zvictory/cashflow/3d-models/toy-dump-truck/stl/02_chassis.stl

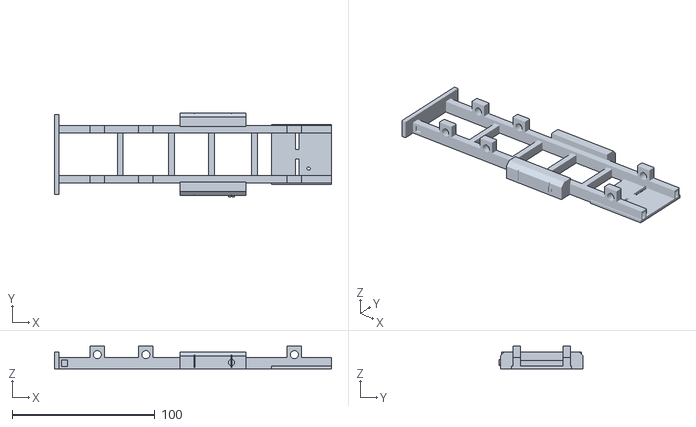
[picture p5: CAD file, 2026-10-25]
3d-models/toy-dump-truck/stl/02_chassis.stl
194.0 x 59.0 x 16.0
