zvictory/cashflow/3d-models/toy-dump-truck/stl/fit_test/T2_chassis_front_crop.stl

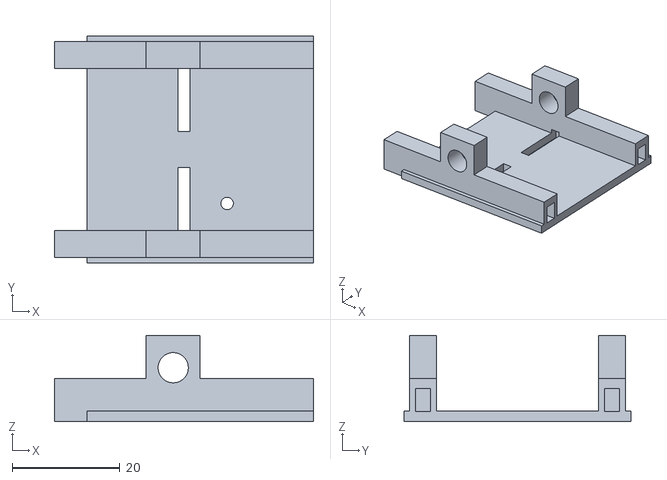
[picture p6: CAD file, 2026-10-25]
3d-models/toy-dump-truck/stl/fit_test/T2_chassis_front_crop.stl
48.0 x 42.0 x 16.0
