zvictory/cashflow/3d-models/toy-dump-truck/stl/15_bed_hinge_right.stl

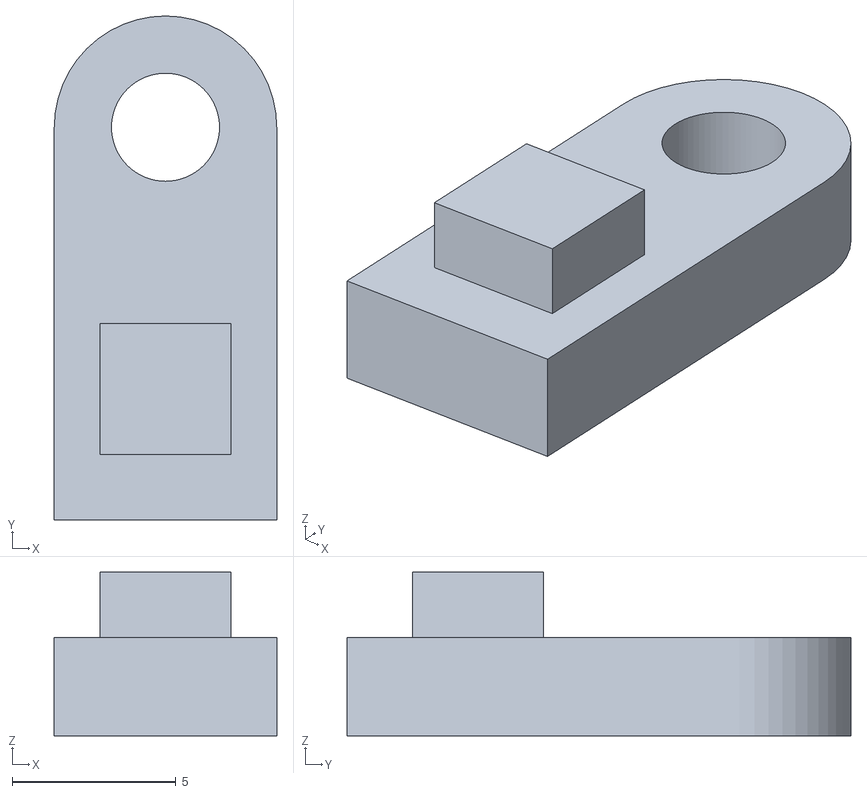
[picture p7: CAD file, 2026-10-25]
3d-models/toy-dump-truck/stl/15_bed_hinge_right.stl
6.80 x 15.4 x 5.00
