zvictory/cashflow/3d-models/toy-dump-truck/stl/fit_test/T1_chassis_rear_crop.stl

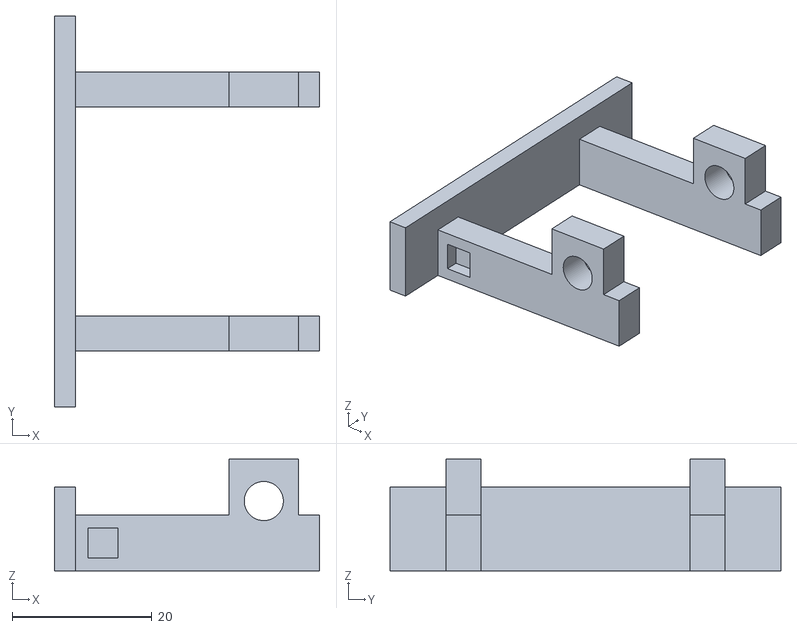
[picture p8: CAD file, 2026-10-25]
3d-models/toy-dump-truck/stl/fit_test/T1_chassis_rear_crop.stl
38.0 x 56.0 x 16.0
