zvictory/cashflow/3d-models/toy-dump-truck/stl/fit_test/T3_bed_pivot_crop.stl

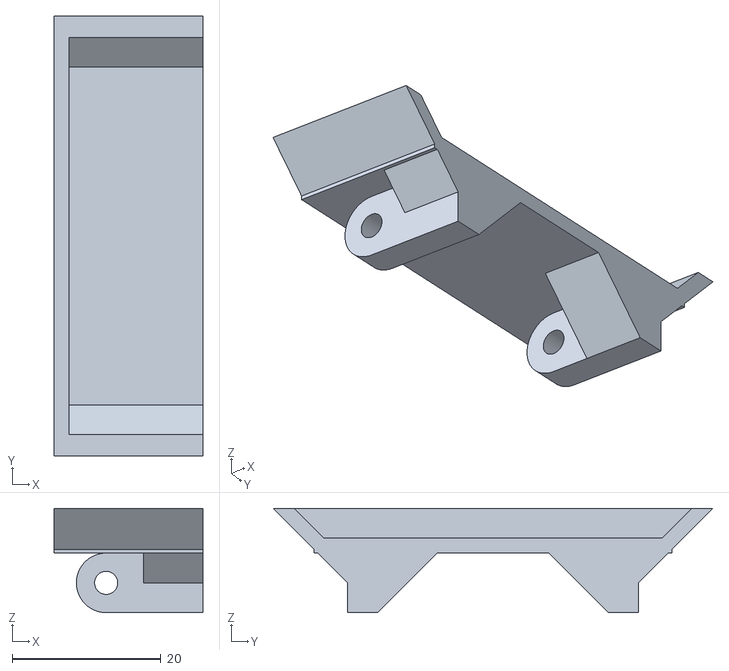
[picture p9: CAD file, 2026-10-25]
3d-models/toy-dump-truck/stl/fit_test/T3_bed_pivot_crop.stl
20.0 x 59.0 x 14.0
