zvictory/cashflow/3d-models/toy-dump-truck/stl/07_steering_wheel.stl

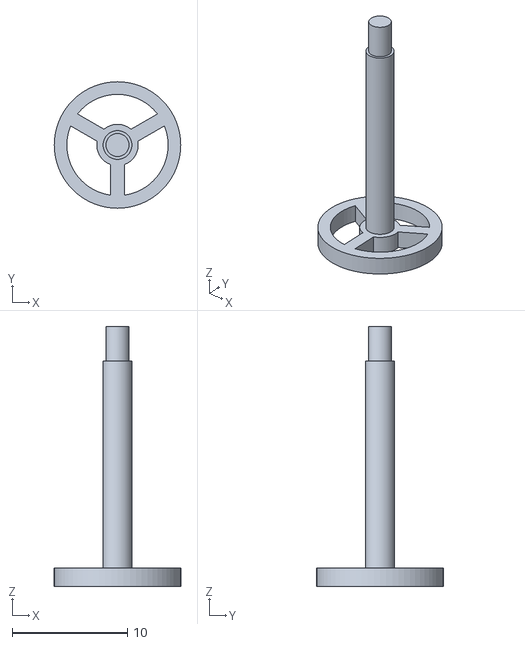
[picture p10: CAD file, 2026-10-25]
3d-models/toy-dump-truck/stl/07_steering_wheel.stl
11.0 x 11.0 x 22.6
