zvictory/cashflow/3d-models/toy-dump-truck/stl/06_seat_x2.stl

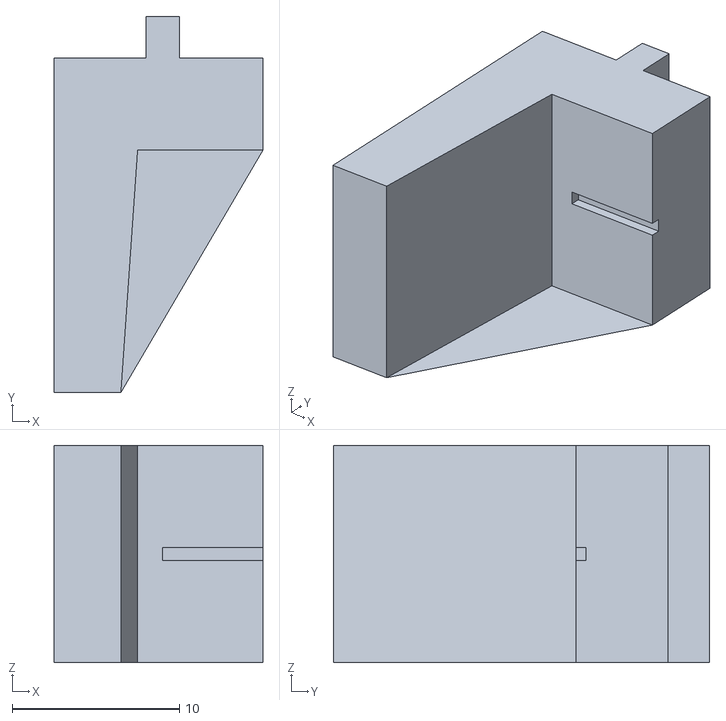
[picture p11: CAD file, 2026-10-25]
3d-models/toy-dump-truck/stl/06_seat_x2.stl
12.5 x 22.5 x 13.0
