zvictory/cashflow/3d-models/toy-dump-truck/stl/10_wheel_rim_x6.stl

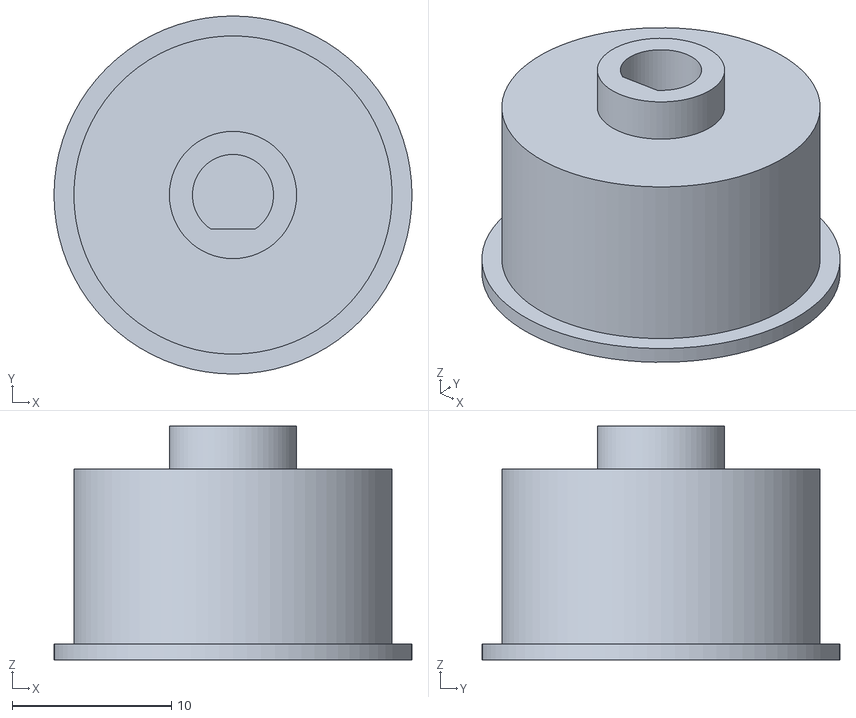
[picture p12: CAD file, 2026-10-25]
3d-models/toy-dump-truck/stl/10_wheel_rim_x6.stl
22.5 x 22.5 x 14.7
