zvictory/cashflow/3d-models/toy-dump-truck/stl/03_dump_bed.stl

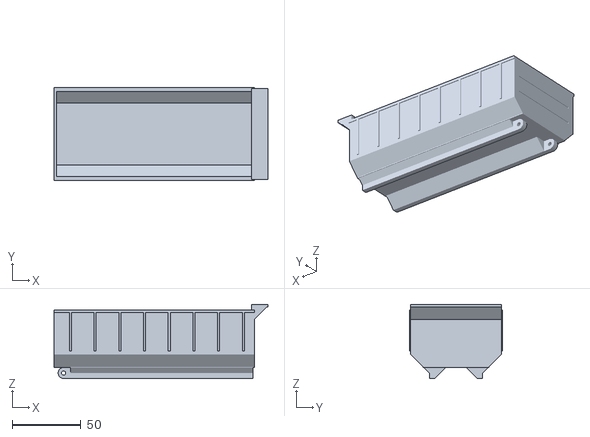
[picture p13: CAD file, 2026-10-25]
3d-models/toy-dump-truck/stl/03_dump_bed.stl
156.0 x 68.0 x 54.0
