zvictory/cashflow/3d-models/toy-dump-truck/stl/09_exhaust_pipe.stl

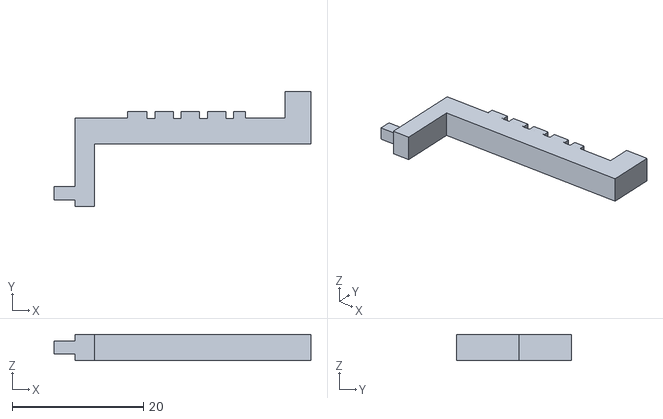
[picture p14: CAD file, 2026-10-25]
3d-models/toy-dump-truck/stl/09_exhaust_pipe.stl
39.2 x 17.5 x 4.02
