zvictory/cashflow/3d-models/toy-dump-truck/stl/01_cabin.stl

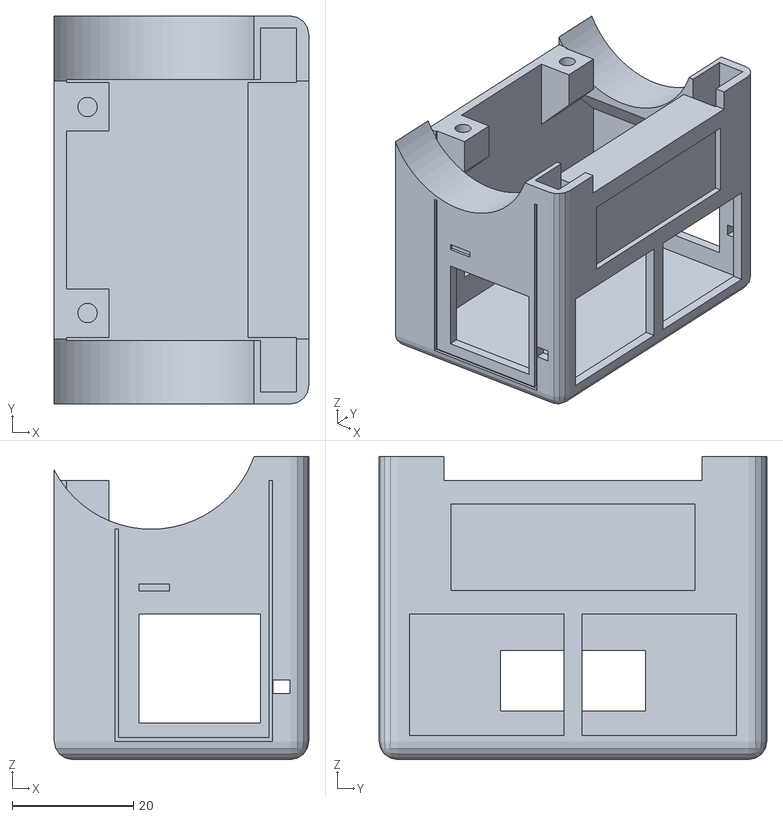
[picture p15: CAD file, 2026-10-25]
3d-models/toy-dump-truck/stl/01_cabin.stl
42.0 x 64.0 x 50.0
