zvictory/cashflow/3d-models/toy-dump-truck/stl/11_tire_x6_TPU.stl

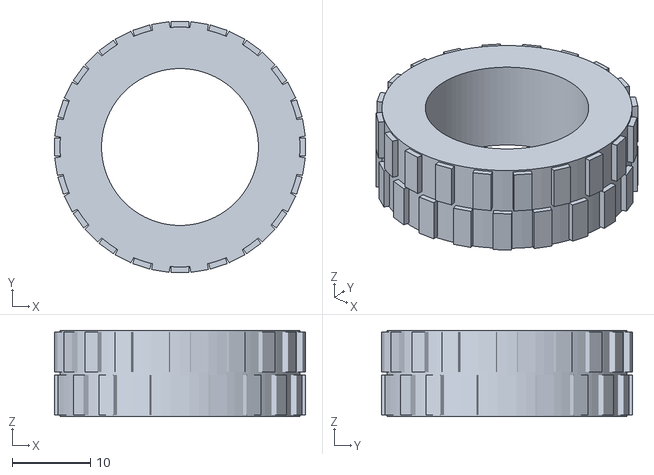
[picture p16: CAD file, 2026-10-25]
3d-models/toy-dump-truck/stl/11_tire_x6_TPU.stl
32.0 x 32.0 x 11.0
