zvictory/cashflow/3d-models/toy-dump-truck/stl/08_mirror_right.stl

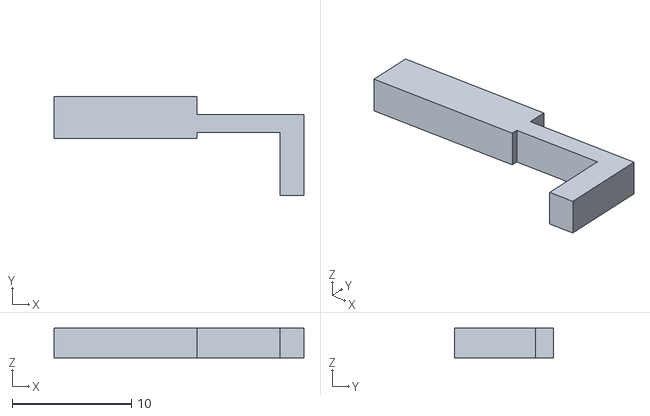
[picture p17: CAD file, 2026-10-25]
3d-models/toy-dump-truck/stl/08_mirror_right.stl
21.0 x 8.30 x 2.50
