zvictory/cashflow/3d-models/toy-dump-truck/stl/14b_pin_cabin_x2.stl

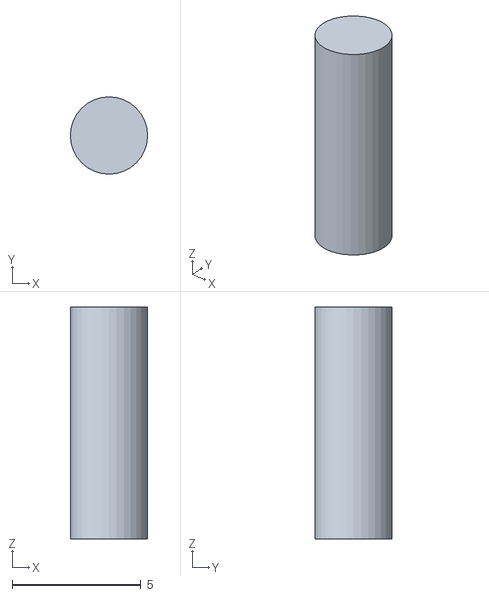
[picture p18: CAD file, 2026-10-25]
3d-models/toy-dump-truck/stl/14b_pin_cabin_x2.stl
3.00 x 3.00 x 9.00
