zvictory/cashflow/3d-models/toy-dump-truck/stl/14a_pin_hinge_x2.stl

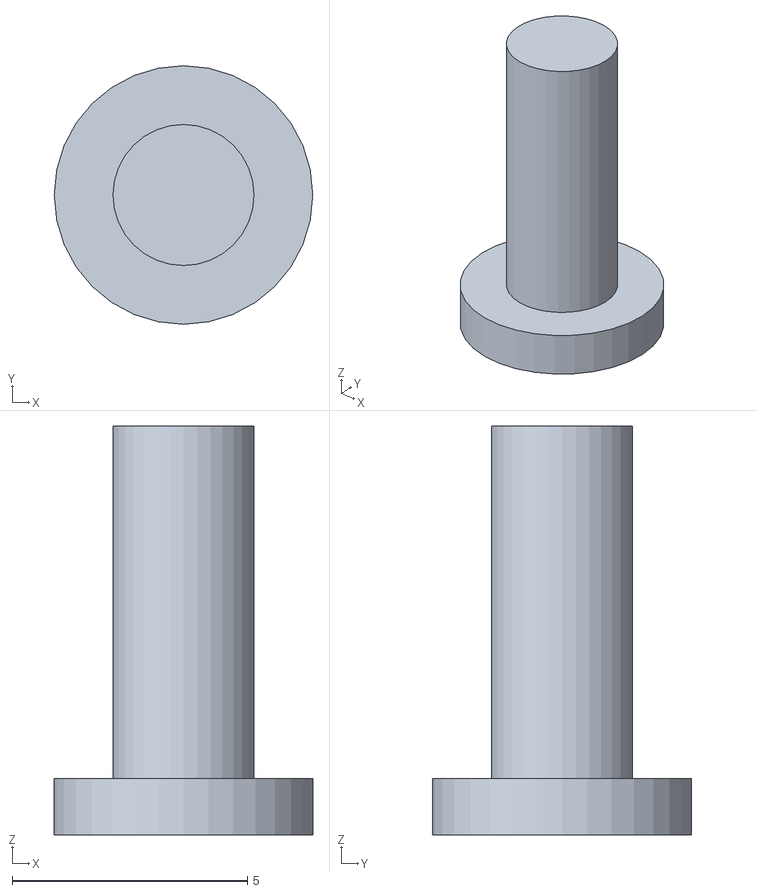
[picture p19: CAD file, 2026-10-25]
3d-models/toy-dump-truck/stl/14a_pin_hinge_x2.stl
5.50 x 5.50 x 8.70
