zvictory/cashflow/3d-models/toy-dump-truck/stl/12_front_axle.stl

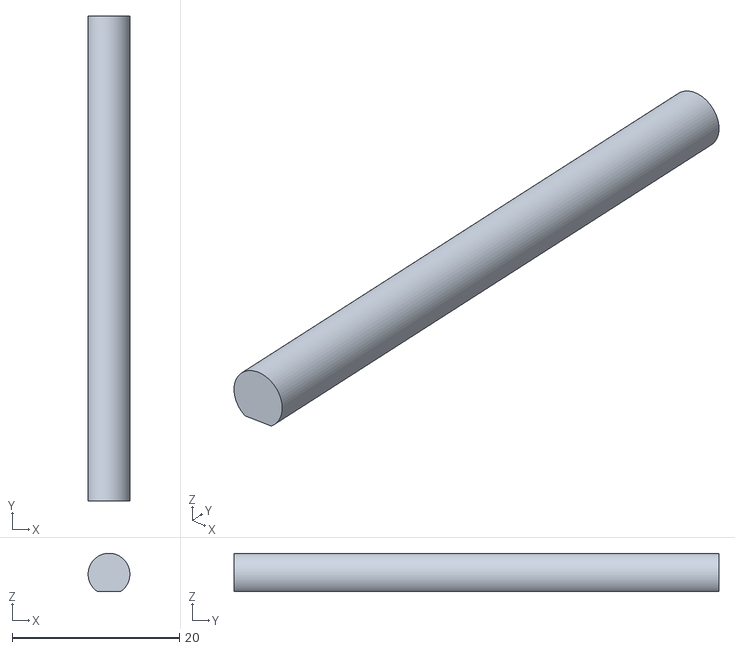
[picture p20: CAD file, 2026-10-25]
3d-models/toy-dump-truck/stl/12_front_axle.stl
5.00 x 58.0 x 4.60
