zvictory/cashflow/3d-models/toy-dump-truck/stl/05_grille.stl

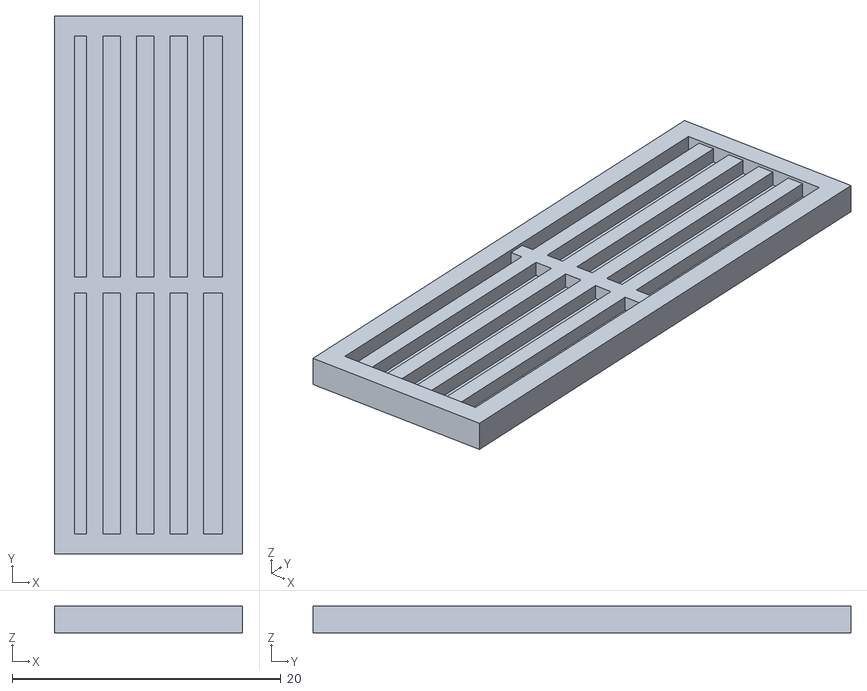
[picture p21: CAD file, 2026-10-25]
3d-models/toy-dump-truck/stl/05_grille.stl
14.0 x 40.0 x 2.00
