zvictory/cashflow/3d-models/toy-dump-truck/stl/04_front_bumper.stl

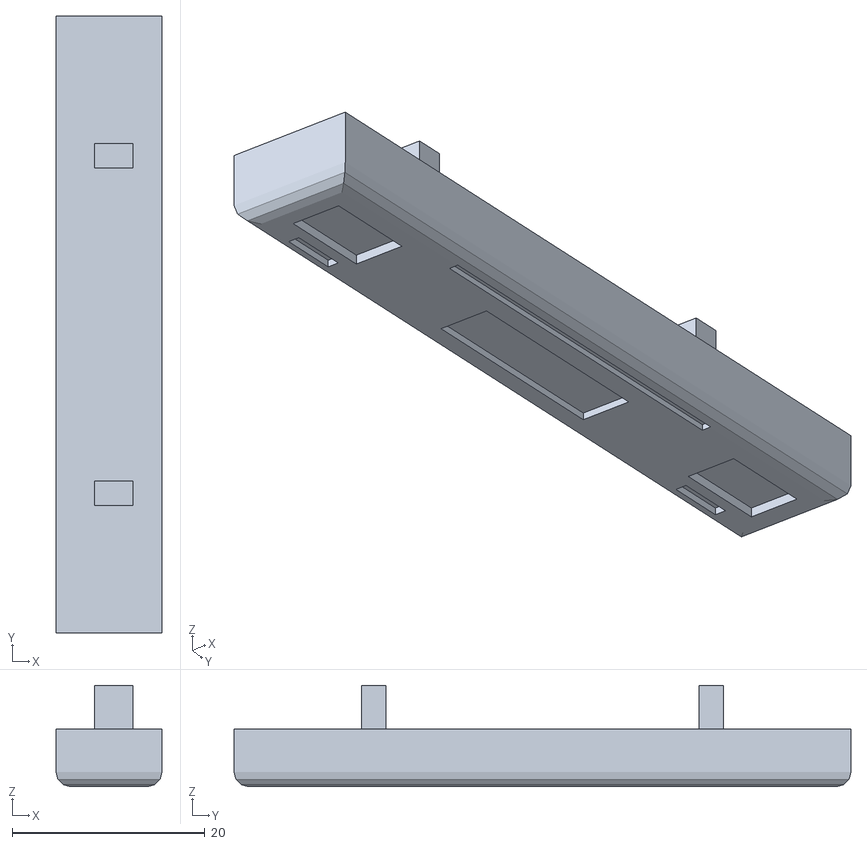
[picture p22: CAD file, 2026-10-25]
3d-models/toy-dump-truck/stl/04_front_bumper.stl
11.0 x 64.0 x 10.5
