zvictory/cashflow/(list of files, cad)

Other CAD files:
3d-models/toy-dump-truck/stl/15_bed_hinge_left.stl
3d-models/toy-dump-truck/stl/13_rear_axle_x2.stl
3d-models/toy-dump-truck/stl/08_mirror_left.stl
3d-models/toy-dump-truck/dump_truck.blend
