zvictory/cashflow/(commit log)

2026-05-10 Add Dynamic Belt — Glass Manufacturing (APAC) sales deck
    Python-pptx generator that builds a 17-slide widescreen pitch deck
    targeted at plant & maintenance managers in APAC glass plants. Covers
    industry pulse, downtime cost math, APAC market sizing & share,
    growth outlook, full belt portfolio (hot-end, cold-end, transmission),
    technical differentiators, case study, 3-year TCO, service model,
    roadmap, and a 90-day pilot CTA.
    Design system (navy / amber / steel) is centralised at the top of
    build_presentation.py so the deck can be re-themed in one place.
    Charts and tables are native python-pptx so they remain editable in
    PowerPoint. Illustrative figures are flagged on data slides for
    swap-o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
2026-10-25 Add print-ready parametric Blender model of toy dump truck
    Parametric Blender script generating 15 part types (32 prints) at
    200x70x80 mm, oriented for support-free FDM printing, with STL exports,
    .blend file, validation (manifold, collisions, tipping, overhangs) and
    preview renders.
    Claude-Session: https://claude.ai/code/session_019NtpaGHrNuipE228LDkZiM
    [01_cabin.stl, 02_chassis.stl, 03_dump_bed.stl, 04_front_bumper.stl, 05_grille.stl, 06_seat_x2.stl, 07_steering_wheel.stl, 08_mirror_left.stl]
2026-10-25 Add joint-by-joint fit check, fix steering, hinge and seat issues
    - fit_check.py: measures clearance/engagement for all 15 mating joints,
    functional gaps, simulates the 31-step assembly sequence, and writes
    fit-test coupons cut from the real parts (stl/fit_test/).
    - Steering wheel moved/shrunk so the cabin can be lowered over it.
    - Hinge arc radius 3.4 mm restores the designed 0.6 mm tip clearance.
    - Seat rebuilt to remove a folded (mis-triangulated) side face;
    validate.py now checks every part for coplanar triangle folds.
    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
    [02_chassis.stl, 06_seat_x2.stl, 07_steering_wheel.stl, 15_bed_hinge_left.stl, 15_bed_hinge_right.stl, T1_chassis_rear_crop.stl, T2_chassis_front_crop.stl, T3_bed_pivot_crop.stl]
